frs25frs25/Self-Balancing-Robot/Selvbalanserenderobot/images/robot_circiut_diagram.png

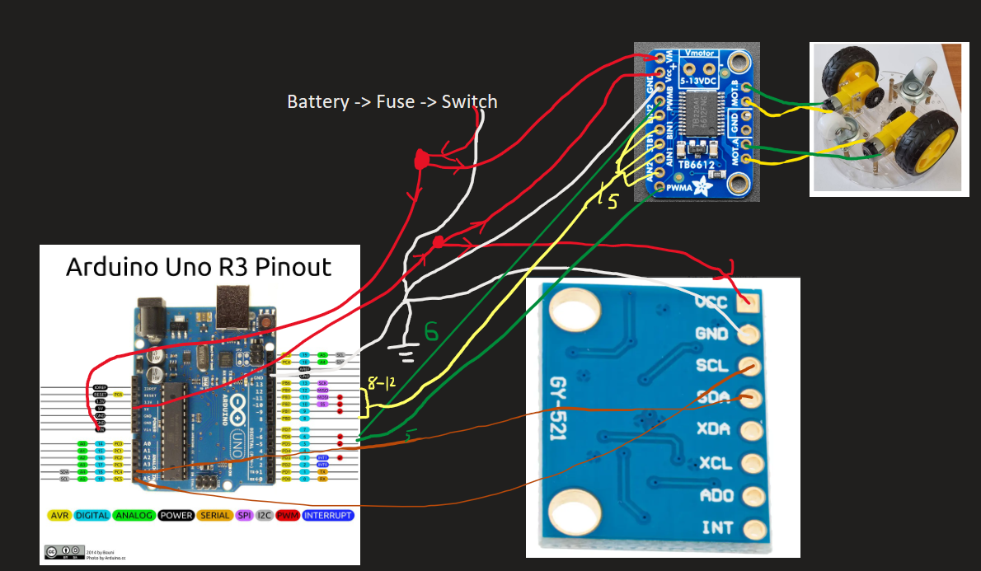
Selvbalanserenderobot/images/robot_circiut_diagram.png
