frs25frs25/Self-Balancing-Robot/Selvbalanserenderobot/images/balancing-robot.png

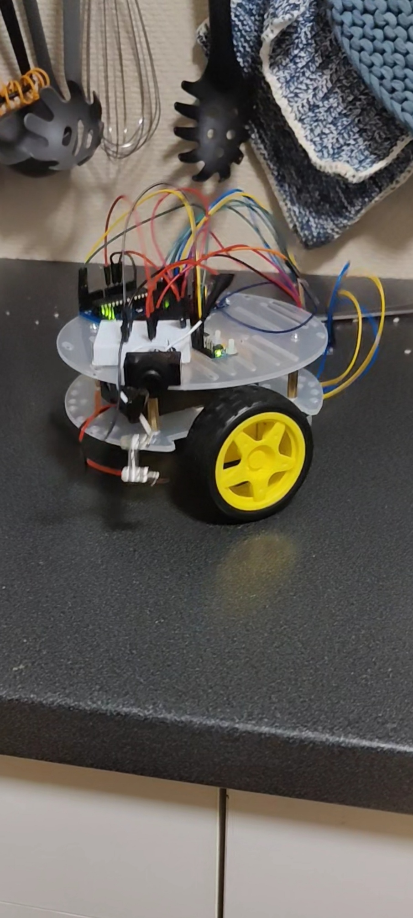
Selvbalanserenderobot/images/balancing-robot.png
