frs25frs25/Self-Balancing-Robot/Selvbalanserenderobot/images/balancing-robot2.png

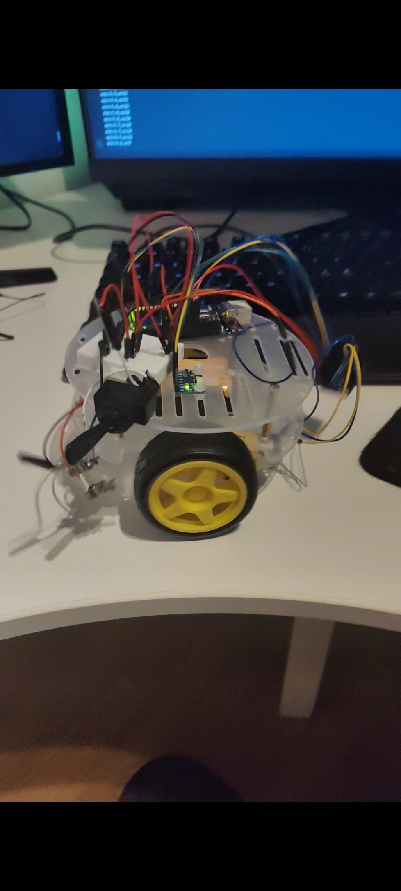
Selvbalanserenderobot/images/balancing-robot2.png
