frs25frs25/Self-Balancing-Robot/(commit log)

2026-09-28 Add self-balancing robot (PID + MPU6050 + TB6612)
2026-09-28 Enhance README with detailed project information
    Updated the README to provide detailed hardware specifications, power connections, working principles, tuning parameters, limitations, and usage instructions for the self-balancing robot.
2026-09-28 Add wiring diagram
